yellobyte/YB-ESP32-S3-AMP/doc/YB-ESP32-S3-AMP_ArduinoIDE_Board-Selection.jpg

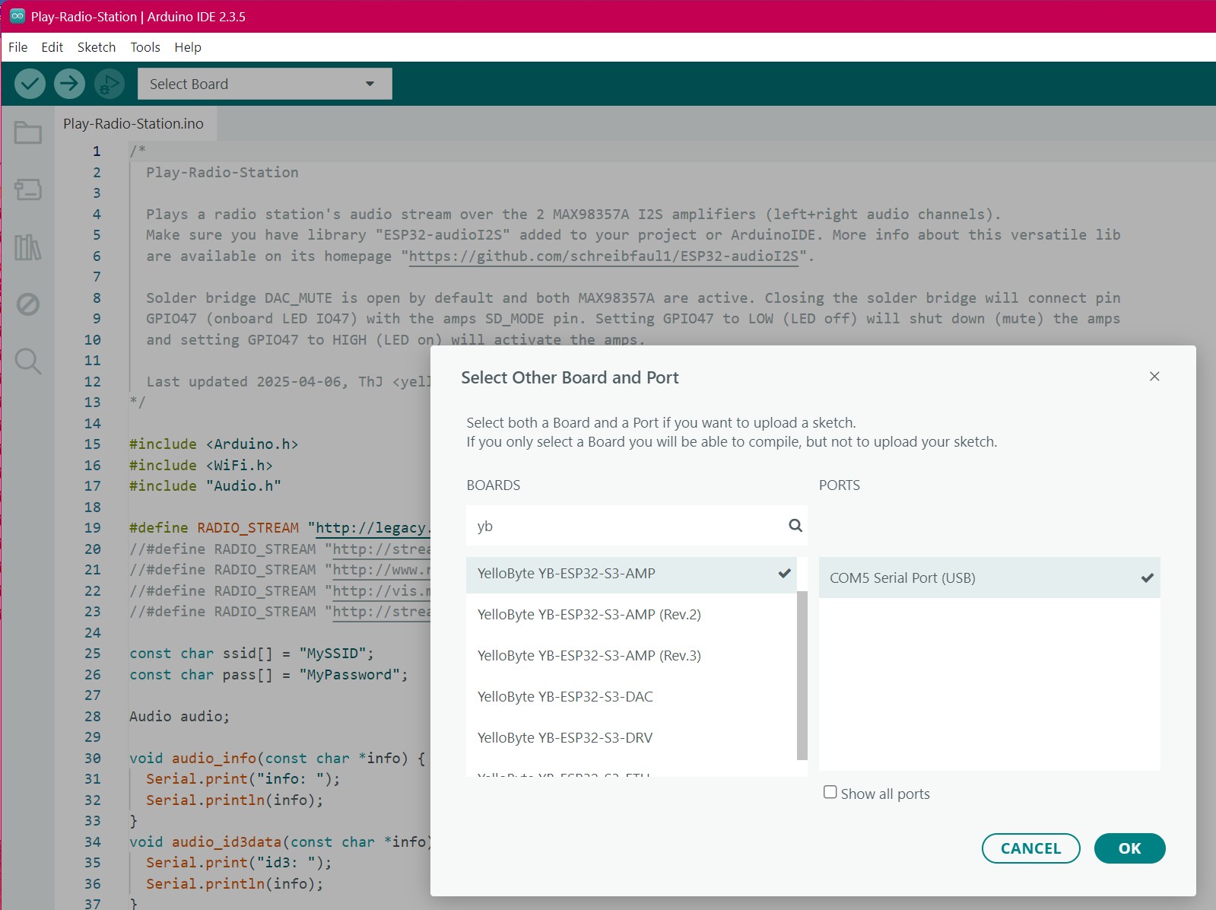
doc/YB-ESP32-S3-AMP_ArduinoIDE_Board-Selection.jpg
