yellobyte/YB-ESP32-S3-AMP/doc/YB-ESP32-S3-AMP_on_breadboard.jpg

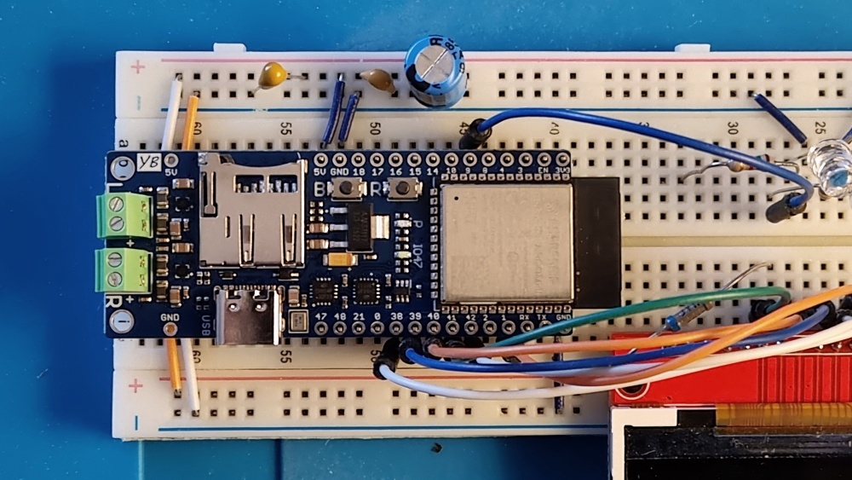
doc/YB-ESP32-S3-AMP_on_breadboard.jpg
