yellobyte/YB-ESP32-S3-AMP/doc/YB-ESP32-S3-AMP_outline.jpg

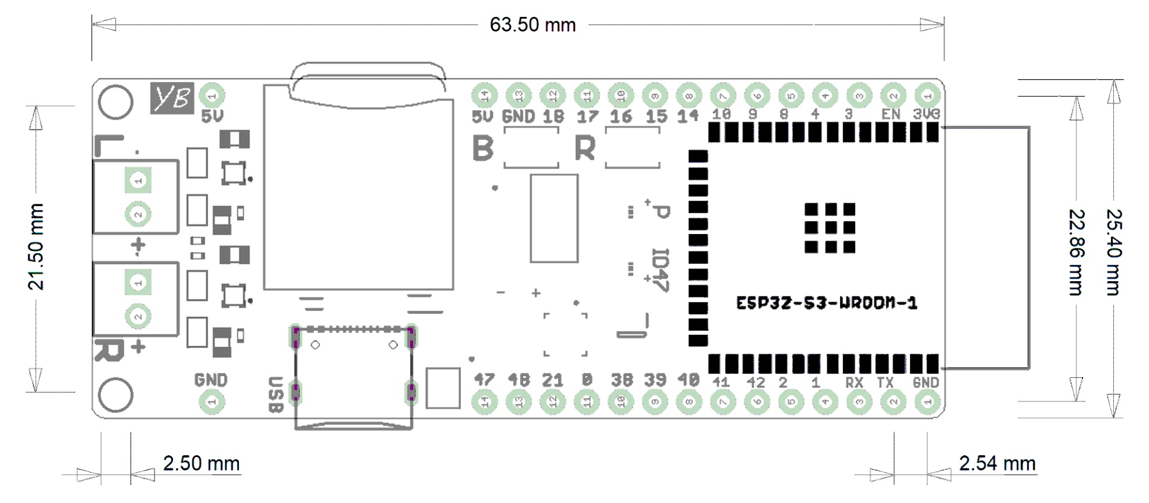
doc/YB-ESP32-S3-AMP_outline.jpg
