yellobyte/YB-ESP32-S3-AMP/doc/YB-ESP32-S3-AMP_schematic_1-2.jpg

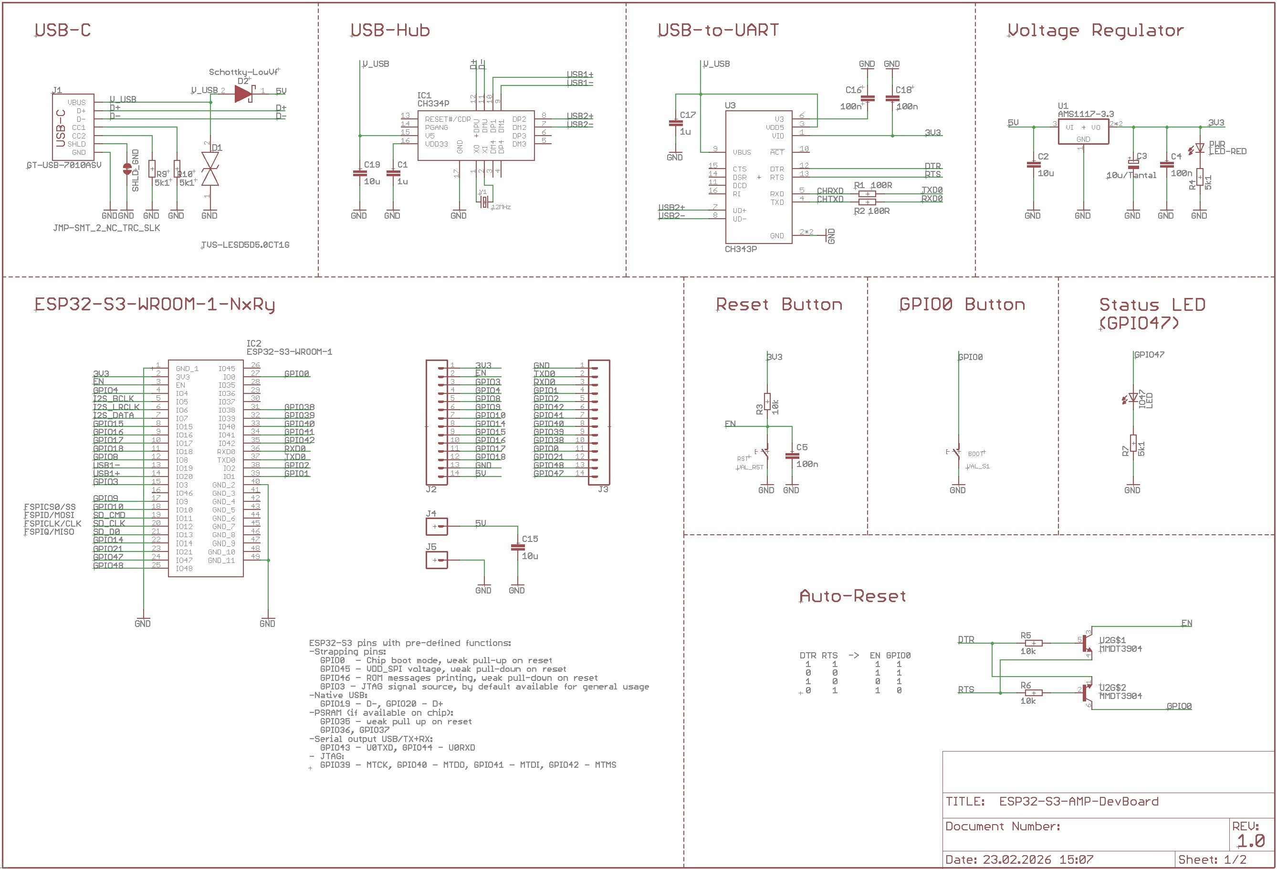
doc/YB-ESP32-S3-AMP_schematic_1-2.jpg
