yellobyte/YB-ESP32-S3-AMP/doc/YB-ESP32-S3-AMP_top_without_screw_terminals.jpg

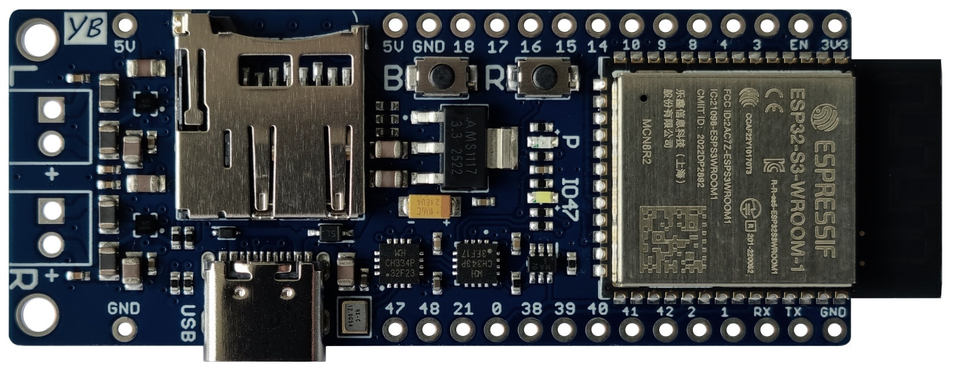
doc/YB-ESP32-S3-AMP_top_without_screw_terminals.jpg
