yellobyte/YB-ESP32-S3-AMP/doc/YB-ESP32-S3-AMP_debug_session.jpg

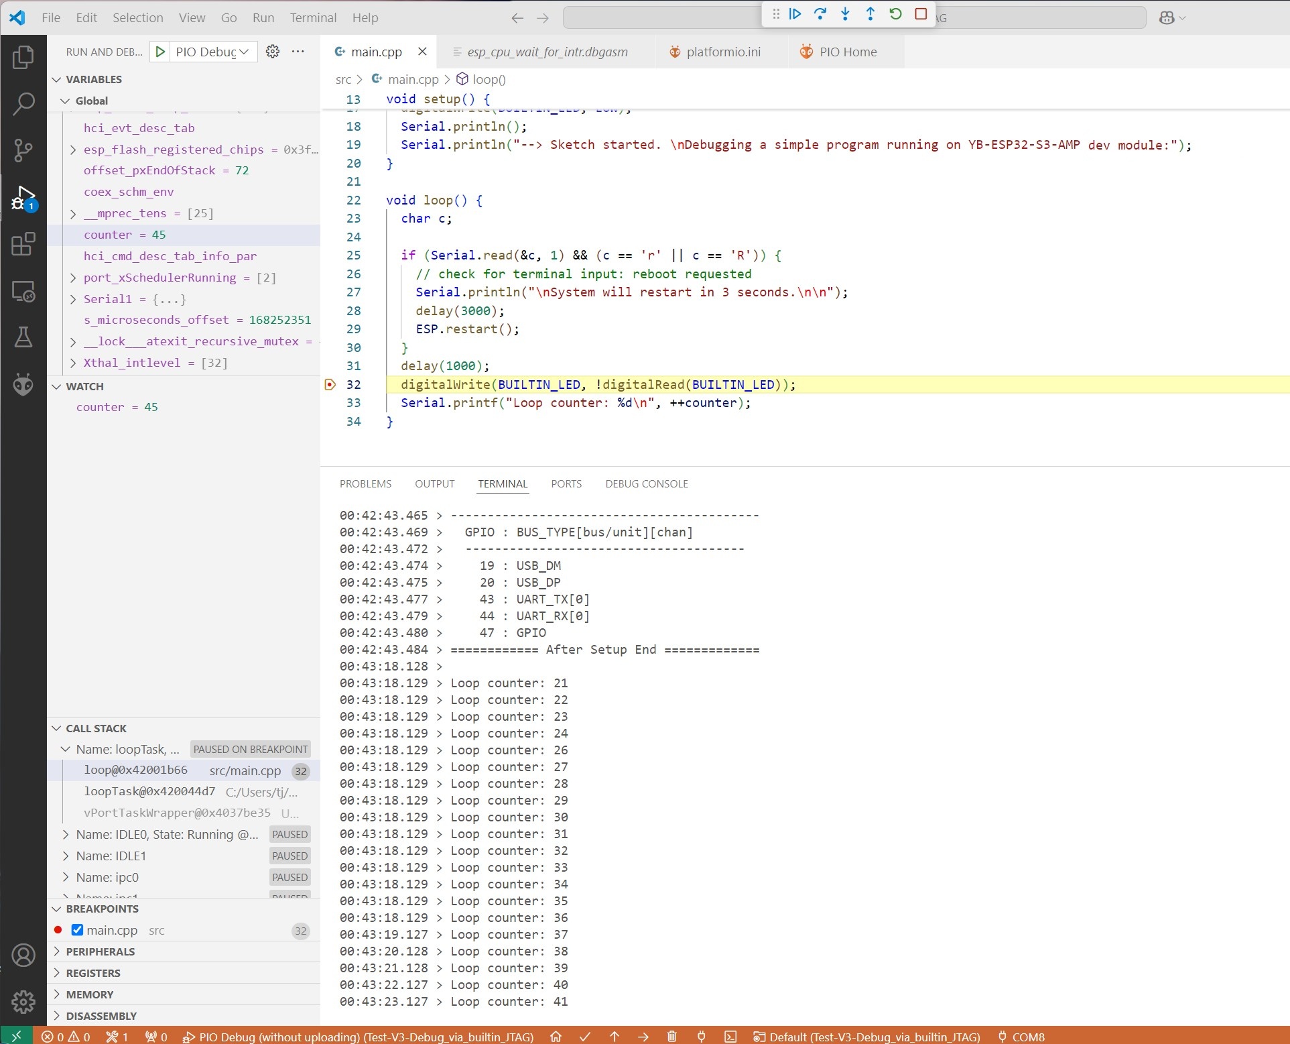
doc/YB-ESP32-S3-AMP_debug_session.jpg
